acageo/automated-industrial-airlock-controller/docs/04-blackbox-validation-and-state-transitions/10-pressurize.jpg

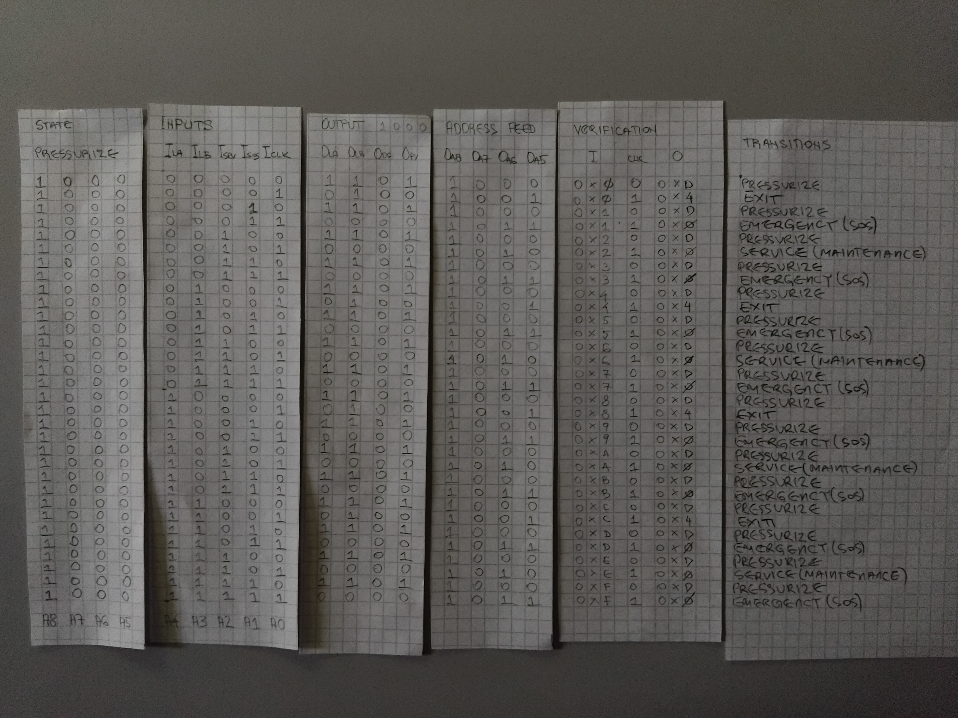
docs/04-blackbox-validation-and-state-transitions/10-pressurize.jpg
