acageo/automated-industrial-airlock-controller/docs/01-state-diagram/state-diagram.jpg

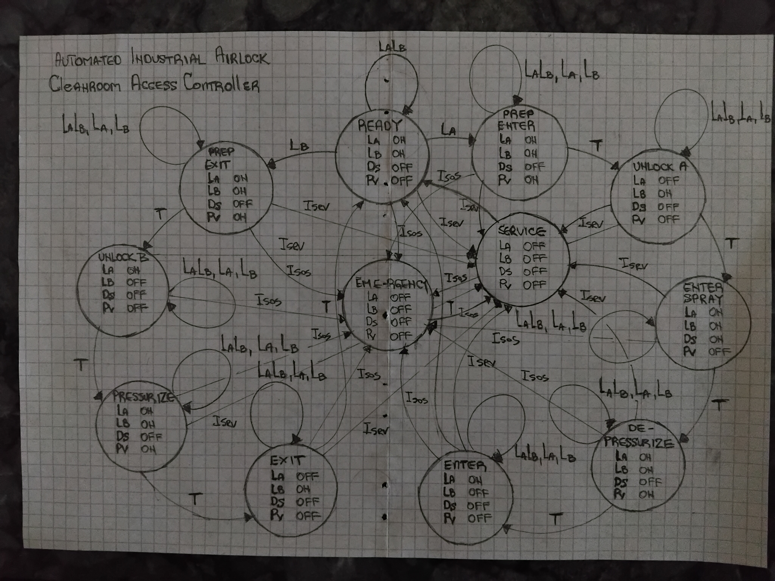
docs/01-state-diagram/state-diagram.jpg
