acageo/automated-industrial-airlock-controller/docs/05-states/01-state-encoding.jpg

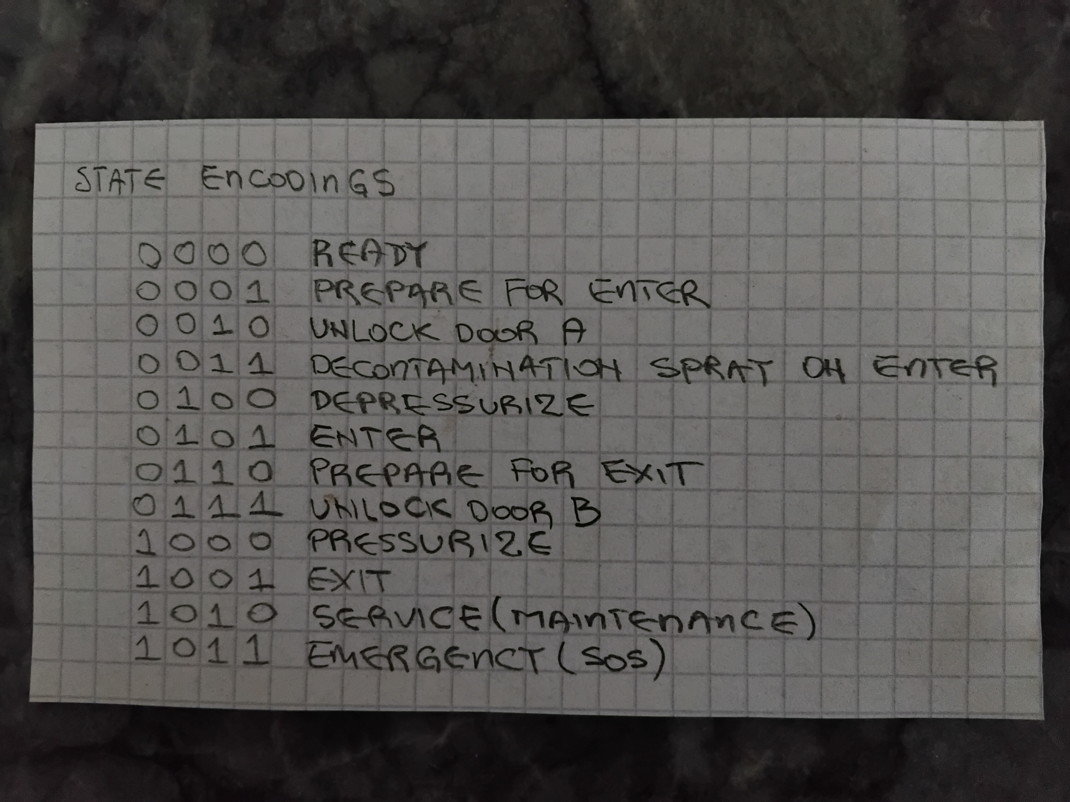
docs/05-states/01-state-encoding.jpg
