acageo/automated-industrial-airlock-controller/docs/05-states/02-state-encodings-to-outuput-mapping.jpg

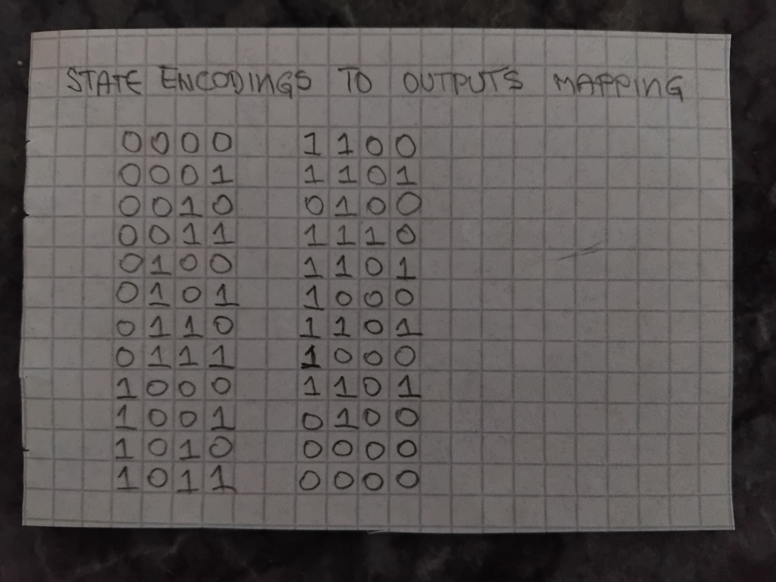
docs/05-states/02-state-encodings-to-outuput-mapping.jpg
