acageo/automated-industrial-airlock-controller/docs/05-states/03-helper-hexadecimal-table.jpg

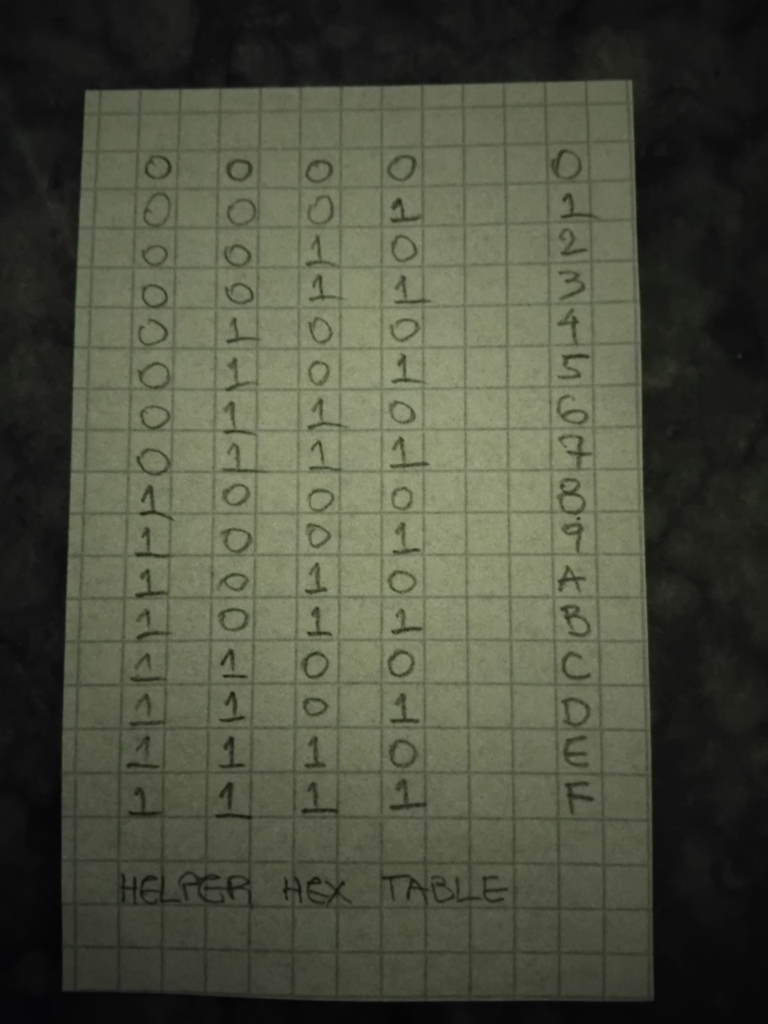
docs/05-states/03-helper-hexadecimal-table.jpg
