acageo/automated-industrial-airlock-controller/docs/06-assets/01-eeprom-programmer/05-ics.jpg

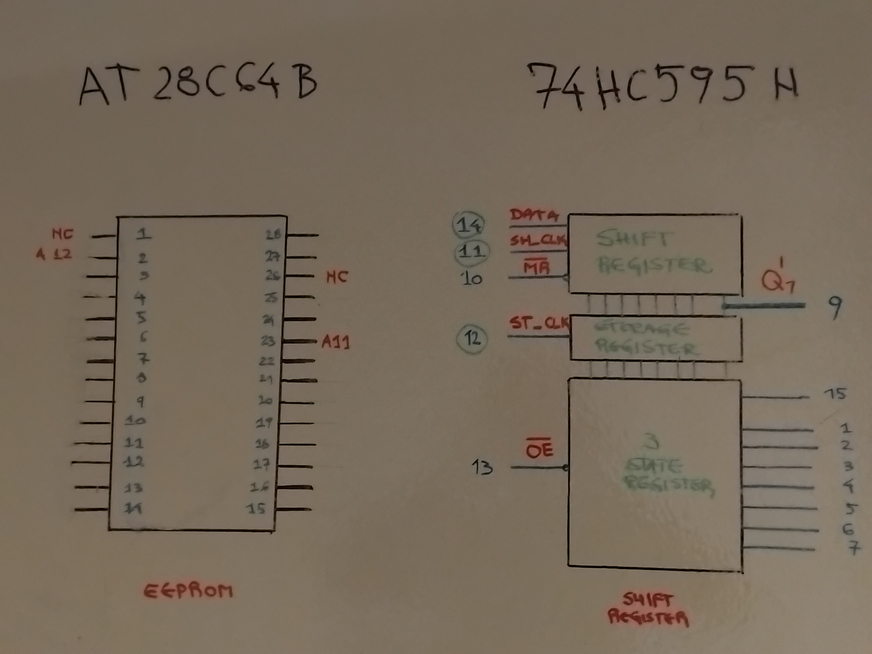
docs/06-assets/01-eeprom-programmer/05-ics.jpg
