acageo/automated-industrial-airlock-controller/docs/06-assets/03-blackbox-validator/02-setup.jpg

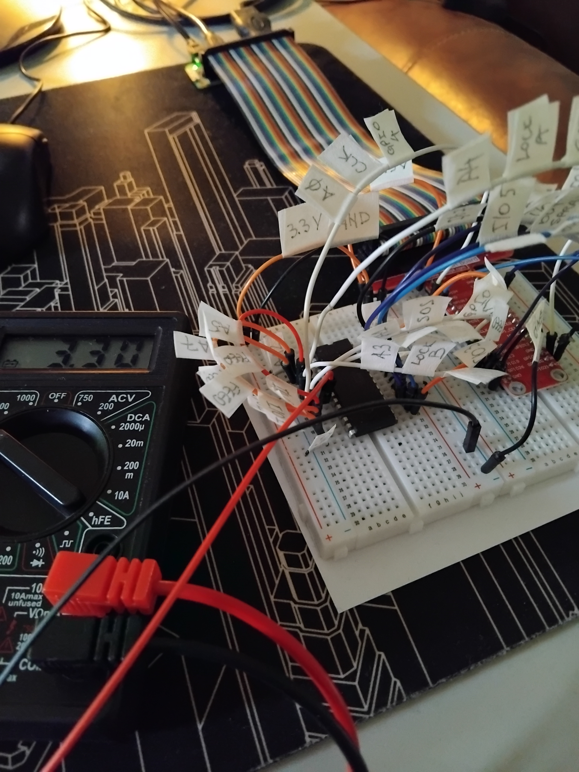
docs/06-assets/03-blackbox-validator/02-setup.jpg
