acageo/automated-industrial-airlock-controller/docs/04-blackbox-validation-and-state-transitions/01-ready.jpg

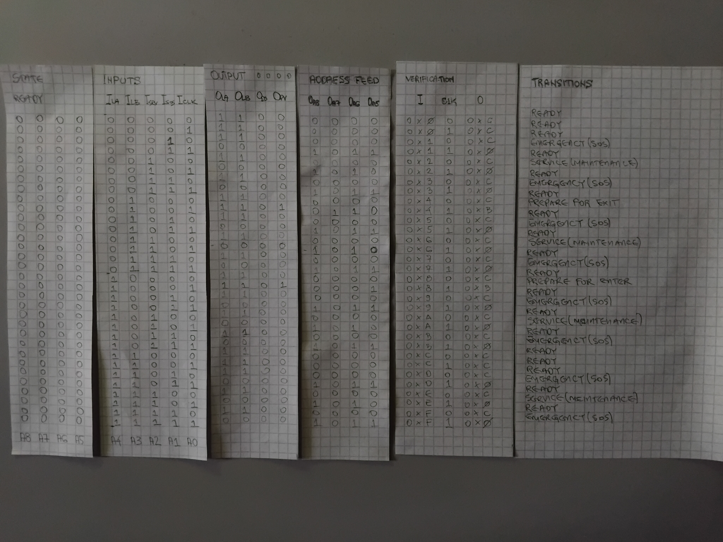
docs/04-blackbox-validation-and-state-transitions/01-ready.jpg
