acageo/automated-industrial-airlock-controller/docs/04-blackbox-validation-and-state-transitions/02-prepare-for-enter.jpg

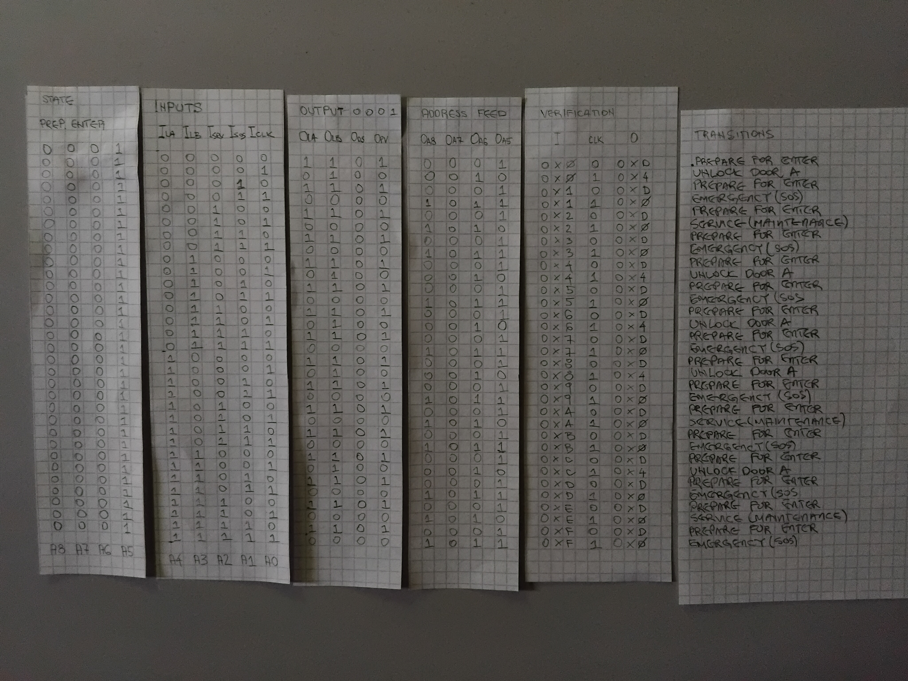
docs/04-blackbox-validation-and-state-transitions/02-prepare-for-enter.jpg
