acageo/automated-industrial-airlock-controller/docs/04-blackbox-validation-and-state-transitions/03-unlock-door-A.jpg

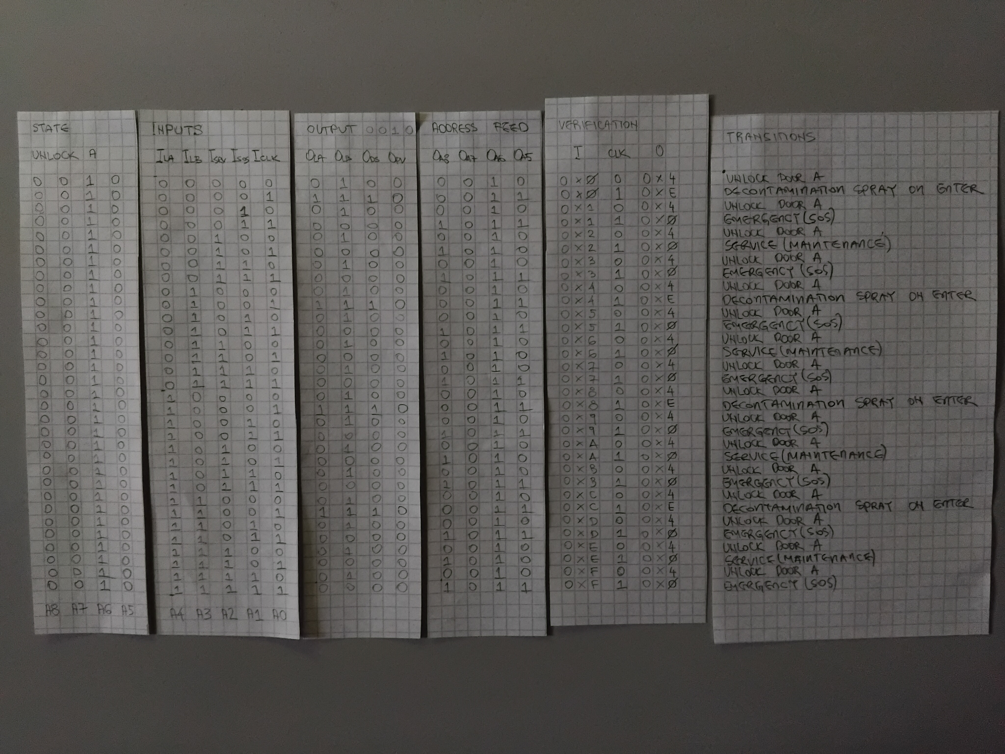
docs/04-blackbox-validation-and-state-transitions/03-unlock-door-A.jpg
