acageo/automated-industrial-airlock-controller/docs/04-blackbox-validation-and-state-transitions/04-decontamination-spray-on-enter.jpg

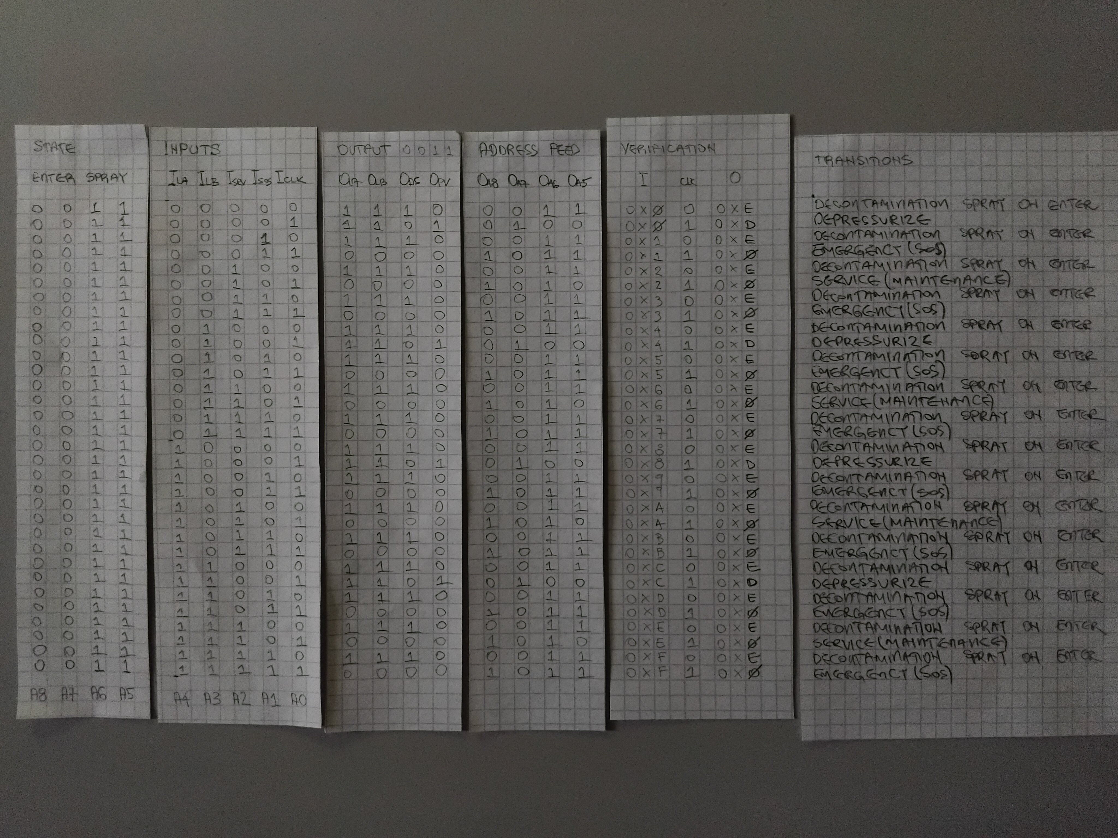
docs/04-blackbox-validation-and-state-transitions/04-decontamination-spray-on-enter.jpg
