acageo/automated-industrial-airlock-controller/docs/04-blackbox-validation-and-state-transitions/05-depressurize.jpg

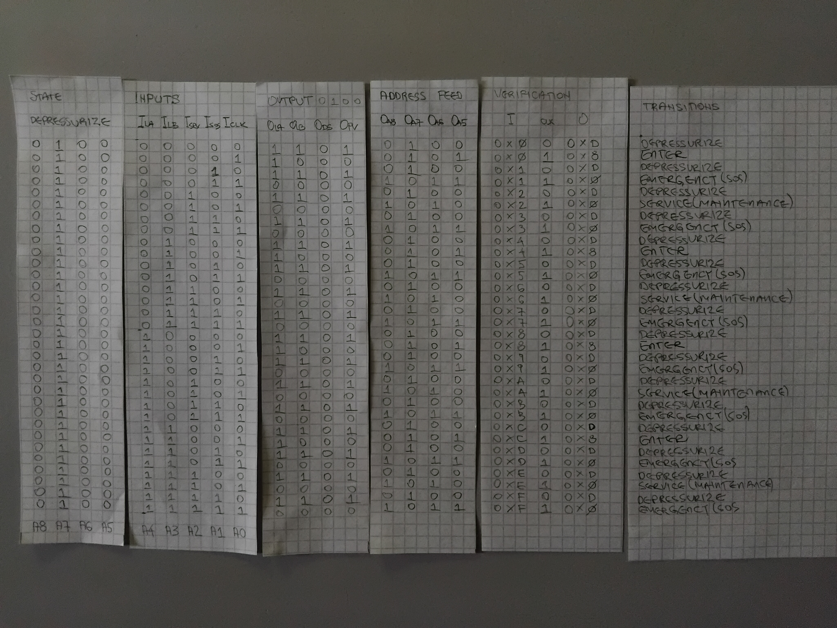
docs/04-blackbox-validation-and-state-transitions/05-depressurize.jpg
