acageo/automated-industrial-airlock-controller/docs/04-blackbox-validation-and-state-transitions/06-enter.jpg

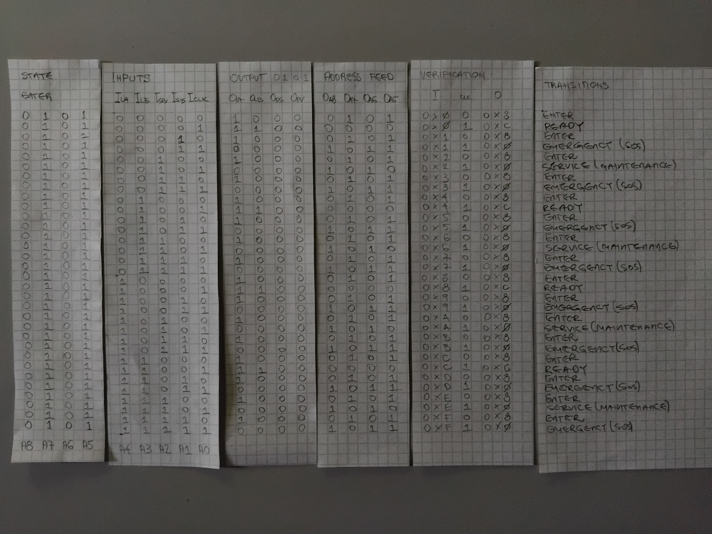
docs/04-blackbox-validation-and-state-transitions/06-enter.jpg
