acageo/automated-industrial-airlock-controller/docs/04-blackbox-validation-and-state-transitions/08-prepare-for-exit.jpg

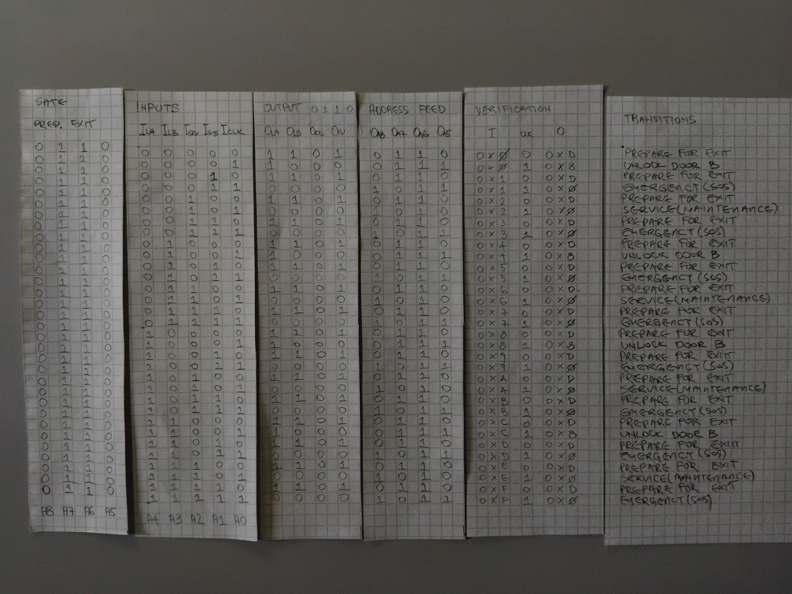
docs/04-blackbox-validation-and-state-transitions/08-prepare-for-exit.jpg
