acageo/automated-industrial-airlock-controller/docs/04-blackbox-validation-and-state-transitions/09-unlock-door-B.jpg

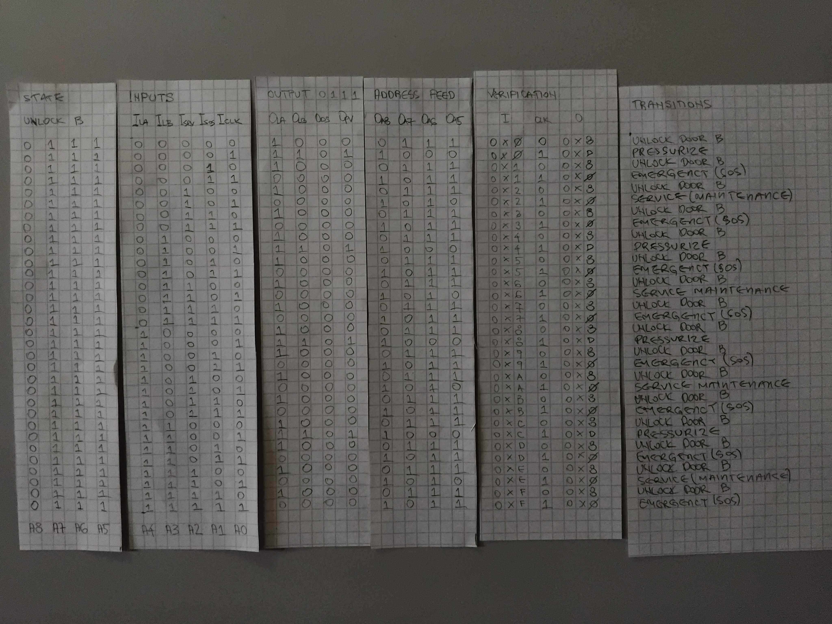
docs/04-blackbox-validation-and-state-transitions/09-unlock-door-B.jpg
