acageo/automated-industrial-airlock-controller/docs/04-blackbox-validation-and-state-transitions/11-exit.jpg

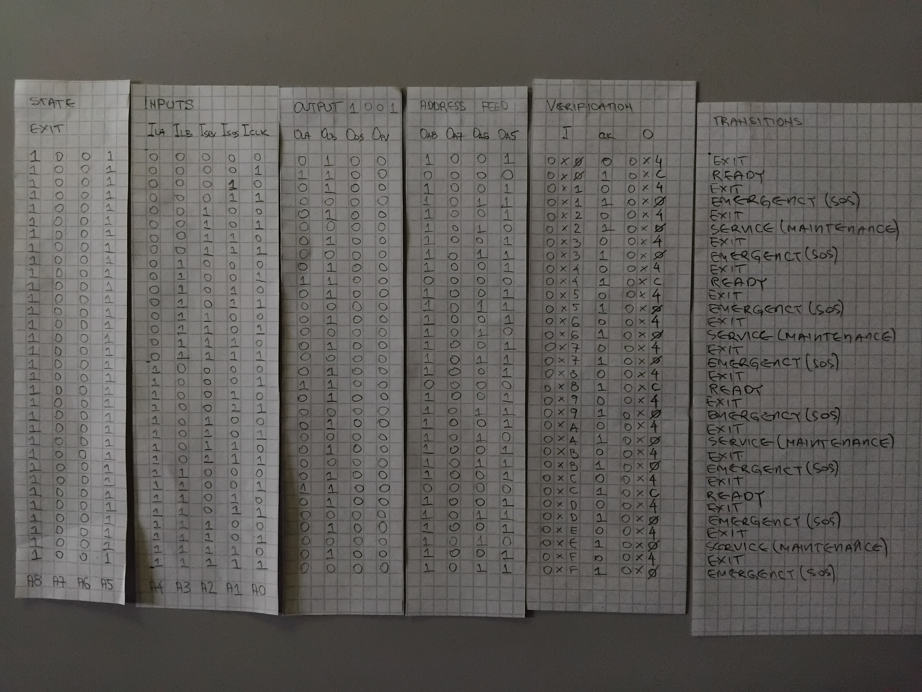
docs/04-blackbox-validation-and-state-transitions/11-exit.jpg
