acageo/automated-industrial-airlock-controller/docs/04-blackbox-validation-and-state-transitions/12-emergency-sos.jpg

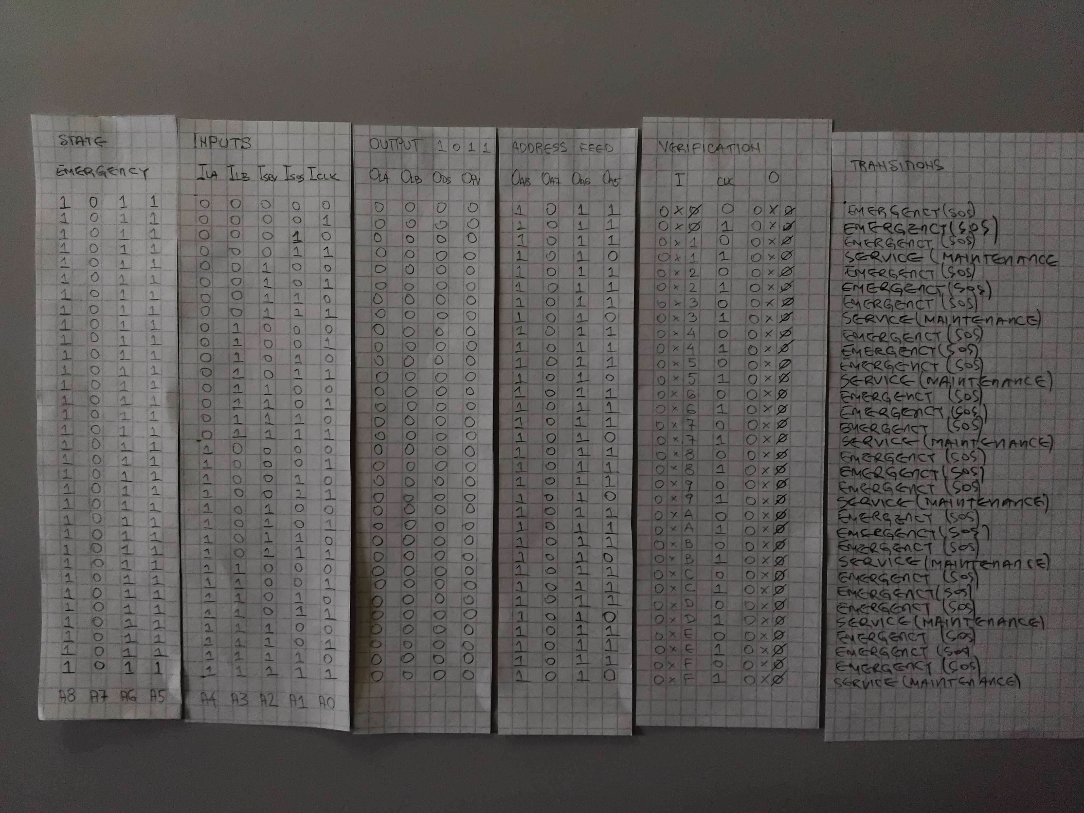
docs/04-blackbox-validation-and-state-transitions/12-emergency-sos.jpg
