acageo/automated-industrial-airlock-controller/docs/04-blackbox-validation-and-state-transitions/07-service-maintenance.jpg

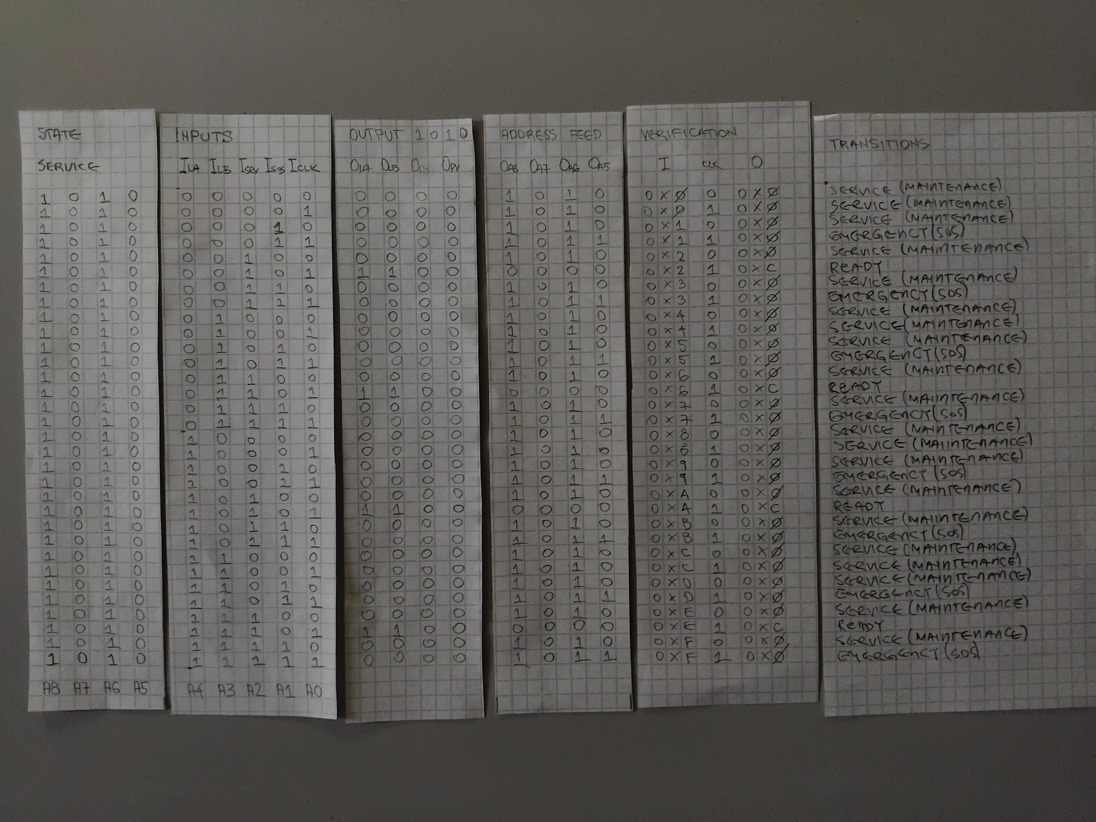
docs/04-blackbox-validation-and-state-transitions/07-service-maintenance.jpg
