acageo/automated-industrial-airlock-controller/(commit log)

2026-10-19 Enhance Readme with offline verification harness details
    Added detailed documentation for the offline FSM verification harness, including system overview, objectives, key engineering breakthroughs, hardware pin mappings, and execution workflow.
2026-10-19 Enhance Readme with Blackbox HIL Validator details
    Added detailed documentation for the Automated Industrial Airlock Blackbox HIL Validator, including system overview, objectives, hardware pin mappings, and transition strategy for atomic bus synchronization.
2026-10-19 Enhance README with project details and instructions
    Expanded the README to include system overview, key capabilities, hardware architecture, pin mapping, and operational workflow for the AT28C64B EEPROM programmer project.
