acageo/automated-industrial-airlock-controller/docs/06-assets/01-eeprom-programmer/01-setup.jpg

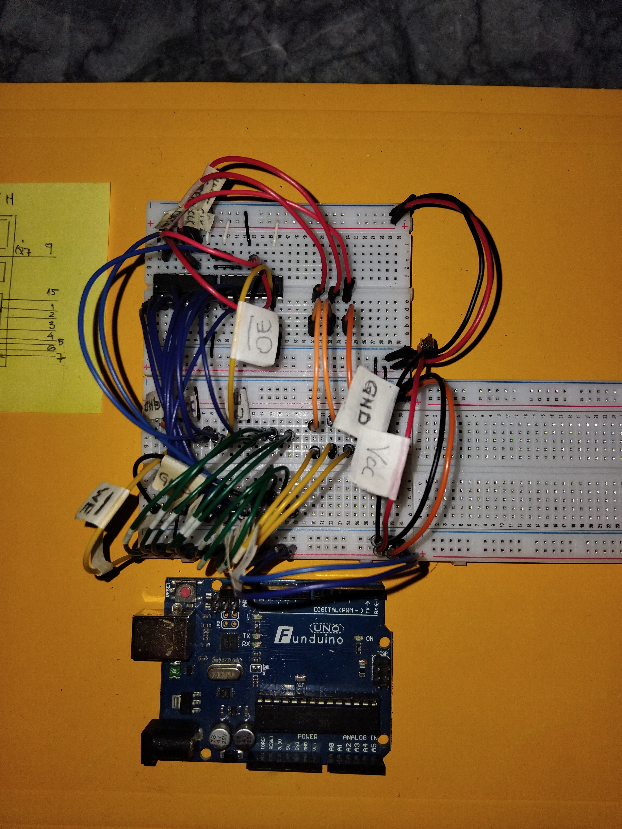
docs/06-assets/01-eeprom-programmer/01-setup.jpg
